EnAccess/Cicada-GSM-HW/design/source/kicad/P-1000010_Okra Cicada 2G PCBA.kicad_pcb

## KiCad design design/source/kicad/P-1000010_Okra Cicada 2G PCBA.kicad_pcb (2026-04-28)

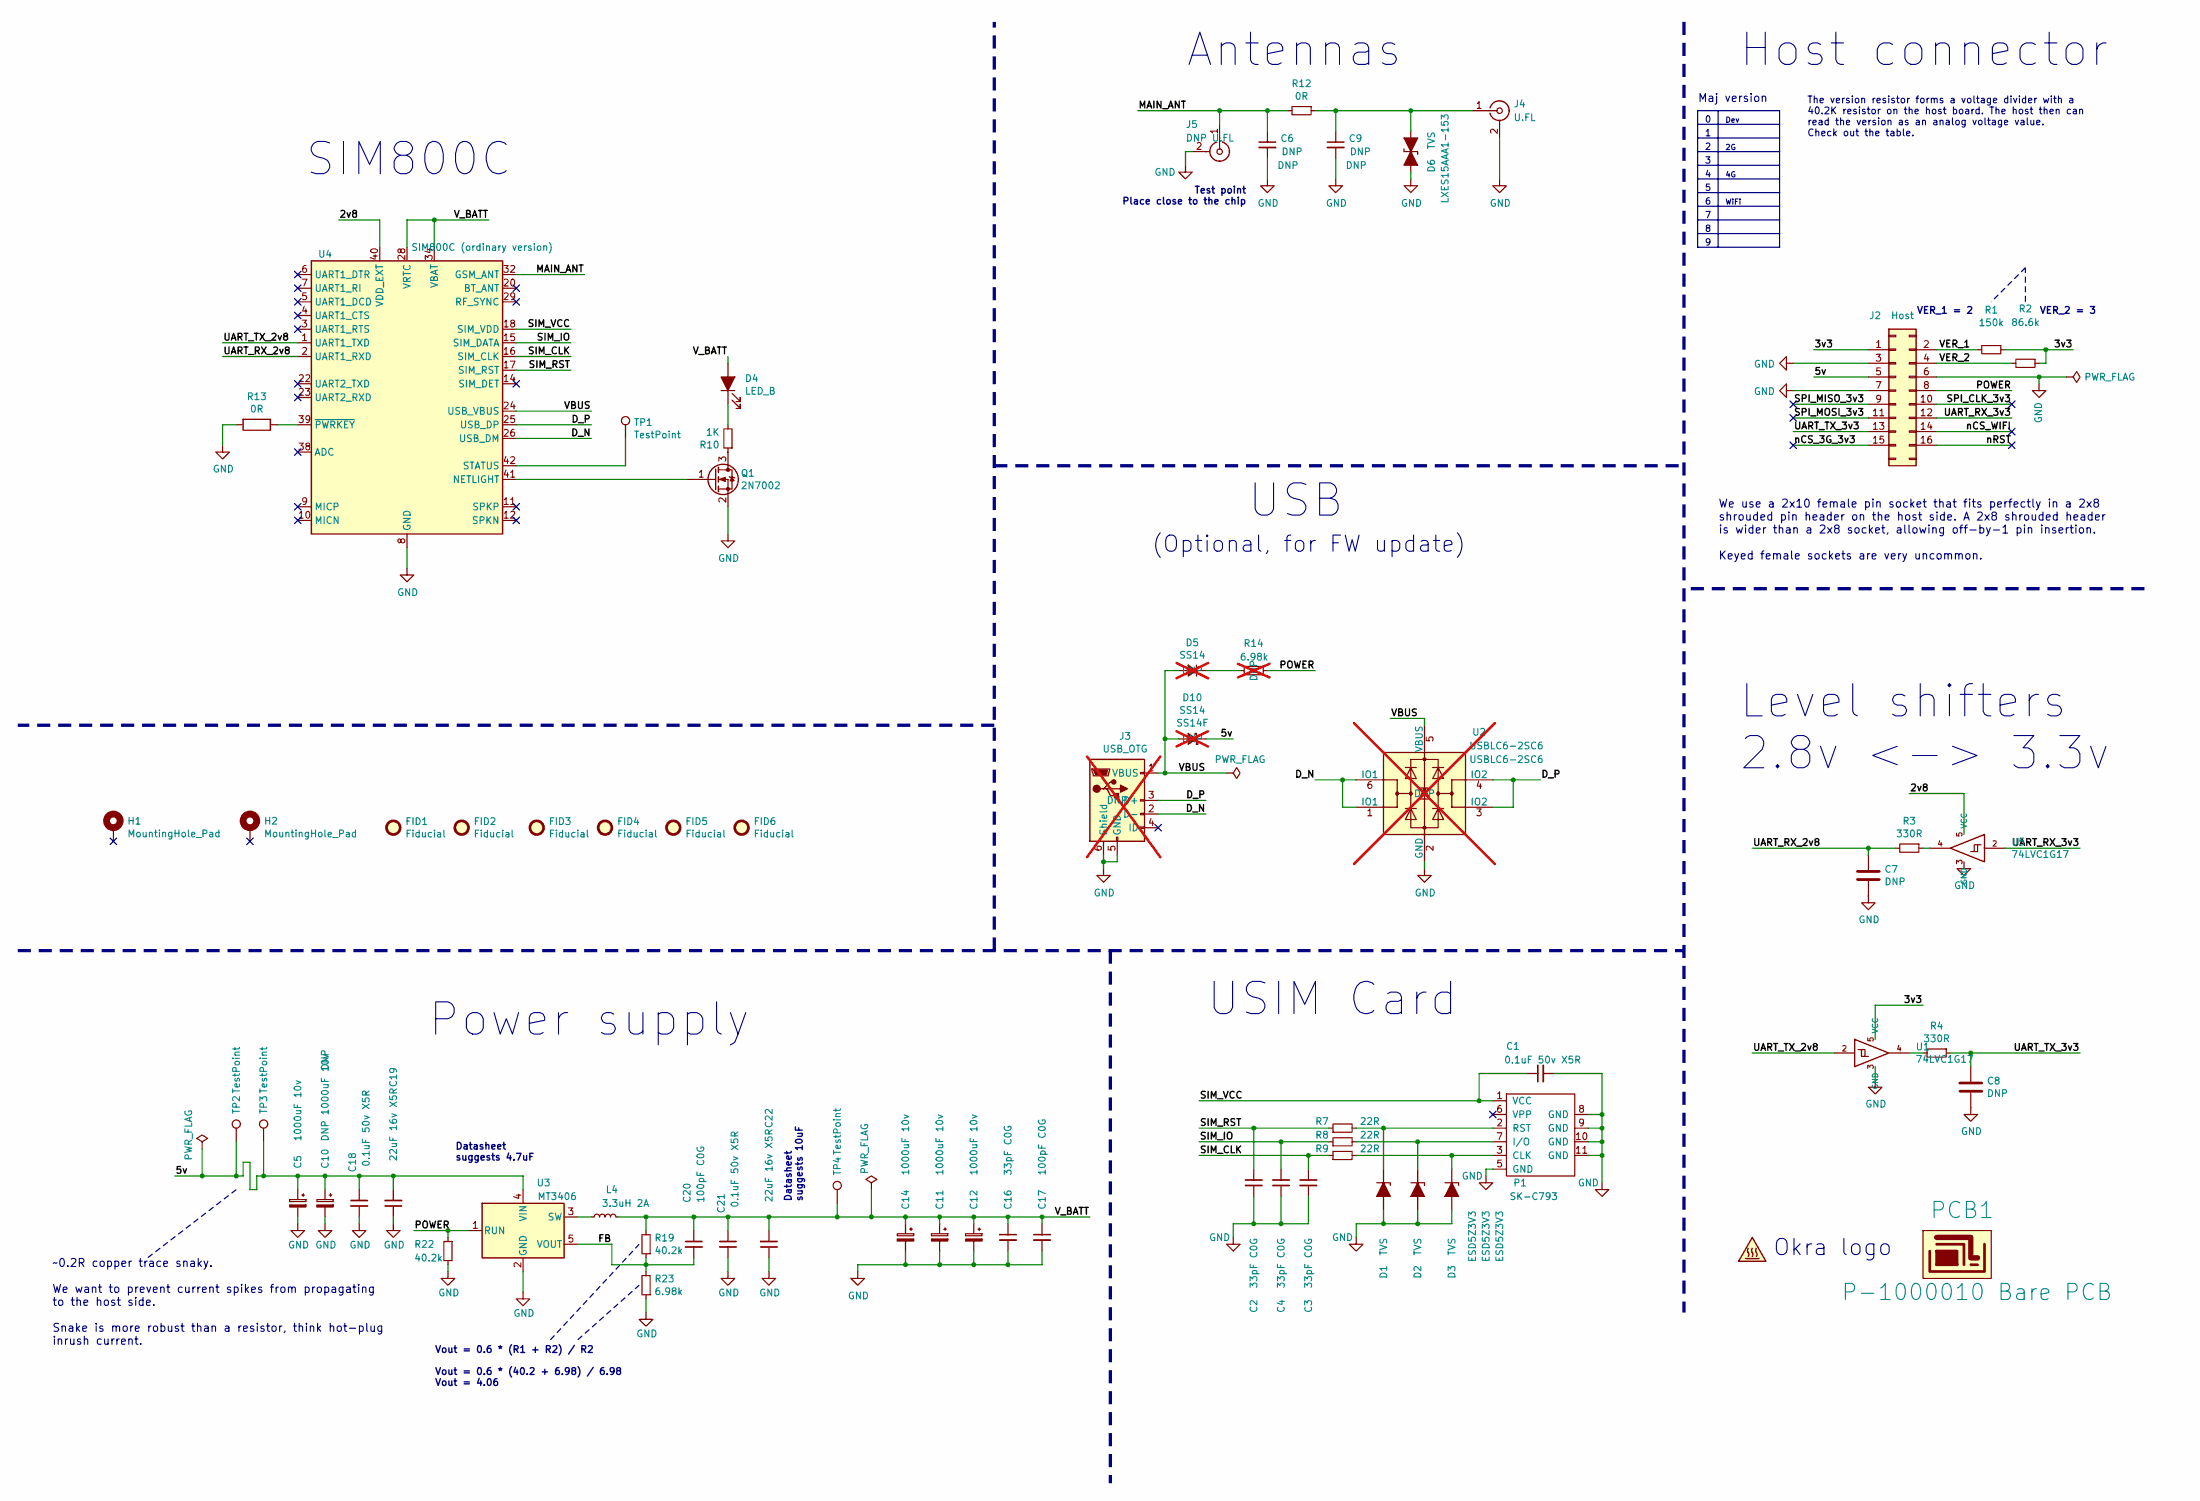
[picture p1: schematic P-1000010_Okra Cicada 2G PCBA.kicad_sch, Ciacada 2G]

Parts:
C1, C18, C21: 0.1uF 50v X5R; C_0603_1608Metric; MPN 0603B104K500NT
C2, C3, C4, C16: 33pF C0G; C_0402_1005Metric; MPN 0402CG330J500NT
C5, C11, C12, C14: 1000uF 10v; CP_Radial_D8.0mm_P3.50mm; MPN GR108M010F12RR0VL4FP0
C6, C7, C8, C9: DNP; C_0402_1005Metric
C10: DNP 1000uF 10v; CP_Radial_D8.0mm_P3.50mm; MPN GR108M010F12RR0VL4FP0
C17, C20: 100pF C0G; C_0402_1005Metric; MPN 0402CG101J500NT
C19, C22: 22uF 16v X5R; C_0805_2012Metric; MPN CL21A226MOQNNNE
D1, D2, D3: TVS; D_SOD-523; MPN ESD5Z3V3
D4: LED_B; D_0603_1608Metric; MPN ORH-B36G
D5, D10: SS14; D_SMA; MPN SS14F; not fitted
D6: TVS; D_0402_1005Metric; MPN LXES15AAA1-153
FID1, FID2, FID3, FID4, FID5, FID6: Fiducial; Fiducial_1mm_Mask2mm
H1, H2: MountingHole_Pad; MountingHole_3.2mm_M3_ISO14580_Pad
J2: Host; PinSocket_2x08_P2.54mm_Vertical_padded; MPN C30867
J3: USB_OTG; ZX62D-B-5PA8; MPN A01SB141B1-067; not fitted
J4: U.FL; U.FL_Molex_MCRF_73412-0110_Vertical; MPN U.FL-R-SMT-1(80)
J5: DNP U.FL; U.FL_Molex_MCRF_73412-0110_Vertical; MPN U.FL-R-SMT-1(80)
L4: 3.3uH 2A; L_4030_Handsoldering; MPN FPI0403F-3R3M
LOGO1: SYM_Hot_Small; okra_logo_copper_2
P1: SK-C793; MPN SK-C793
PCB1: P-1000010 Bare PCB
Q1: 2N7002; SOT-23; MPN 2N7002
R1: 150k; R_0402_1005Metric; MPN RC0402JR-07150KL
R2: 86.6k; R_0402_1005Metric; MPN RC0402FR-0786K6L
R3, R4: 330R; R_0402_1005Metric; MPN RC0402FR-07330RL
R7, R8, R9: 22R; R_0402_1005Metric; MPN RC0402FR-0722RL
R10: 1K; R_0402_1005Metric; MPN RC0402JR-071KL
R12, R13: 0R; R_0402_1005Metric; MPN RC0402FR-070RL
R14: 6.98k; R_0402_1005Metric; MPN RC0402FR-076K98L; not fitted
R19, R22: 40.2k; R_0402_1005Metric; MPN RC0402FR-0740K2L
R23: 6.98k; R_0402_1005Metric; MPN RC0402FR-076K98L
TP1, TP2, TP3, TP4: TestPoint; TestPoint_Pad_D1.5mm
U1, U5: 74LVC1G17; SOT-353_SC-70-5; MPN 74LVC1G17GW
U2: USBLC6-2SC6; SOT-23-6; MPN USBLC6-2SC6; not fitted
U3: MT3406; TSOT-23-5; MPN MT3406
U4: SIM800C (ordinary version); SIMCom_SIM800C; MPN SIM800C

Connections:
/2v8: U4.40 (VDD_EXT), U5.5 (VCC)
/3v3: J2.1, R1.1, R2.1, U1.5 (VCC)
/5v: C5.1, C10.1, C18.1, C19.2, D10.1 (K), J2.5, TP2.1, TP3.1, U3.4 (VIN)
/D_N: J3.2 (D-), U2.1 (IO1), U2.6 (IO1), U4.26 (USB_DM)
/D_P: J3.3 (D+), U2.3 (IO2), U2.4 (IO2), U4.25 (USB_DP)
/FB: C20.2, R19.1, R23.2, U3.5 (VOUT)
/MAIN_ANT: C6.1, J5.1 (In), R12.2, U4.32 (GSM_ANT)
/POWER: J2.8, R14.1, R22.1, U3.1 (RUN)
/SIM_CLK: C3.2, R9.1, U4.16 (SIM_CLK)
/SIM_IO: C4.2, R8.1, U4.15 (SIM_DATA)
/SIM_RST: C2.2, R7.1, U4.17 (SIM_RST)
/SIM_VCC: C1.1, P1.1 (VCC), U4.18 (SIM_VDD)
/SPI_CLK_3v3: J2.10
/SPI_MISO_3v3: J2.9
/SPI_MOSI_3v3: J2.11
/UART_RX_2v8: C7.1, R3.2, U4.2 (UART1_RXD)
/UART_RX_3v3: J2.12, U5.2
/UART_TX_2v8: U1.2, U4.1 (UART1_TXD)
/UART_TX_3v3: C8.1, J2.13, R4.1
/VBUS: D5.2 (A), D10.2 (A), J3.1 (VBUS), U2.5 (VBUS), U4.24 (USB_VBUS)
/VER_1: J2.2, R1.2
/VER_2: J2.4, R2.2
/V_BATT: C11.1, C12.1, C14.1, C16.1, C17.1, C20.1, C21.1, C22.2, D4.2 (A), L4.2, R19.2, TP4.1, U4.28 (VRTC), U4.34 (VBAT), U4.35 (VBAT)
/nCS_3G_3v3: J2.15
/nCS_WIFI: J2.14
/nRST: J2.16
GND: C1.2, C2.1, C3.1, C4.1, C5.2, C6.2, C7.2, C8.2, C9.2, C10.2, C11.2, C12.2, C14.2, C16.2, C17.2, C18.2, C19.1, C21.2, C22.1, D1.2 (A), D2.2 (A), D3.2 (A), D6.2 (A2), J2.3, J2.6, J2.7, J3.5 (GND), J3.6 (Shield), J4.2 (Ext), J5.2 (Ext), P1.5 (GND), P1.8 (GND), P1.9 (GND), P1.10 (GND), P1.11 (GND), Q1.2 (S), R13.2, R22.2, R23.1, U1.3 (GND), U2.2 (GND), U3.2 (GND), U4.8 (GND), U4.13 (GND), U4.19 (GND), U4.21 (GND), U4.27 (GND), U4.30 (GND), U4.31 (GND), U4.33 (GND), U4.36 (GND), U4.37 (GND), U5.3 (GND)
unnamed: C9.1, D6.1 (A1), J4.1 (In), R12.1
unnamed: D1.1 (K), P1.2 (RST), R7.2
unnamed: D2.1 (K), P1.7 (I/O), R8.2
unnamed: D3.1 (K), P1.3 (CLK), R9.2
unnamed: D4.1 (K), R10.2
unnamed: D5.1 (K), R14.2
unnamed: L4.1, U3.3 (SW)
unnamed: Q1.1 (G), U4.41 (NETLIGHT)
unnamed: Q1.3 (D), R10.1
unnamed: R3.1, U5.4
unnamed: R4.2, U1.4
unnamed: R13.1, U4.39 (~PWRKEY)
unnamed: TP1.1, U4.42 (STATUS)

Notes on the sheet:
Datasheet suggests 10uF
Antennas
Power supply
Datasheet suggests 4.7uF
(Optional, for FW update)
Level shifters 2.8v <-> 3.3v
Okra logo
SIM800C
WiFi
USIM Card
The version resistor forms a voltage divider with a 40.2K resistor on the host board. The host then can read the version as an analog voltage value. Check out the table.
USB
Test point Place close to the chip
Maj version
Vout = 0.6 * (R1 + R2) / R2 Vout = 0.6 * (40.2 + 6.98) / 6.98 Vout = 4.06
~0.2R copper trace snaky. We want to prevent current spikes from propagating to the host side. Snake is more robust than a resistor, think hot-plug inrush current.
Dev
We use a 2x10 female pin socket that fits perfectly in a 2x8 shrouded pin header on the host side. A 2x8 shrouded header is wider than a 2x8 socket, allowing off-by-1 pin insertion. Keyed female sockets are very uncommon.
VER_2 = 3
Host connector
VER_1 = 2

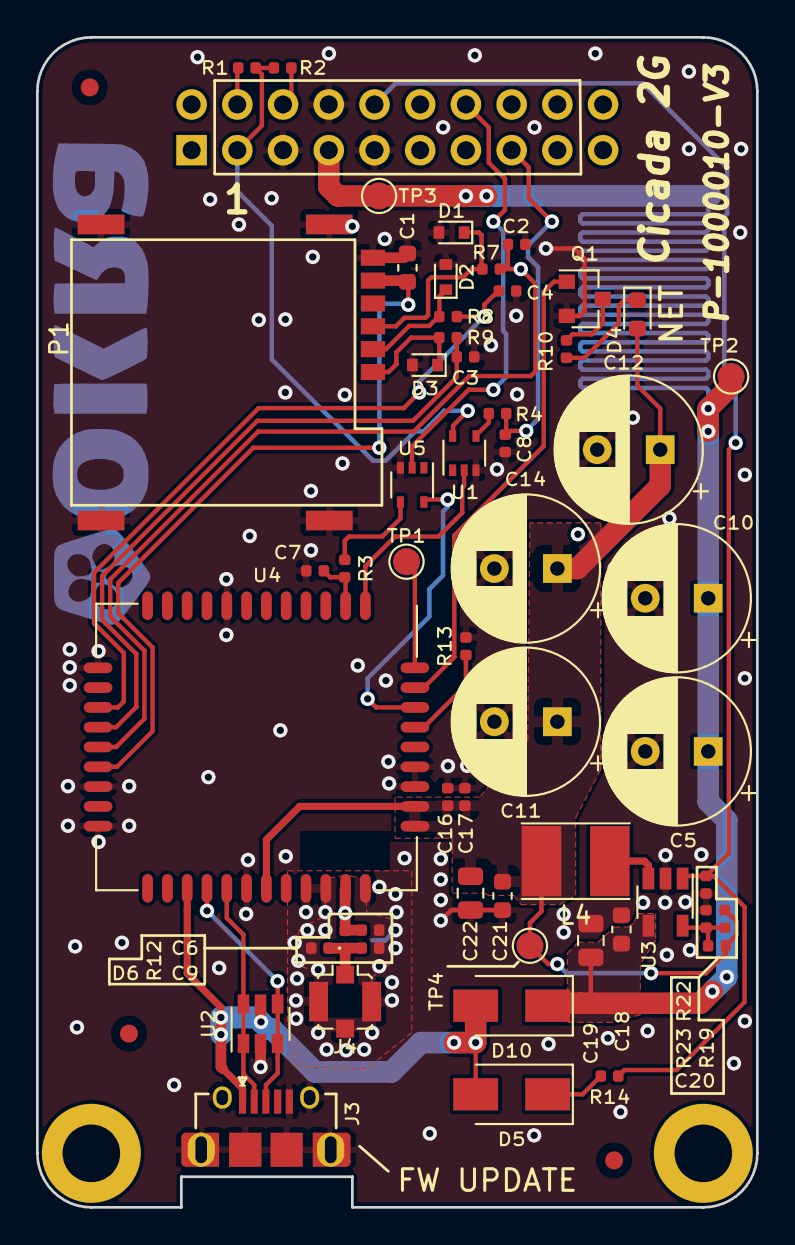
[picture p2: board P-1000010_Okra Cicada 2G PCBA.kicad_pcb from above]

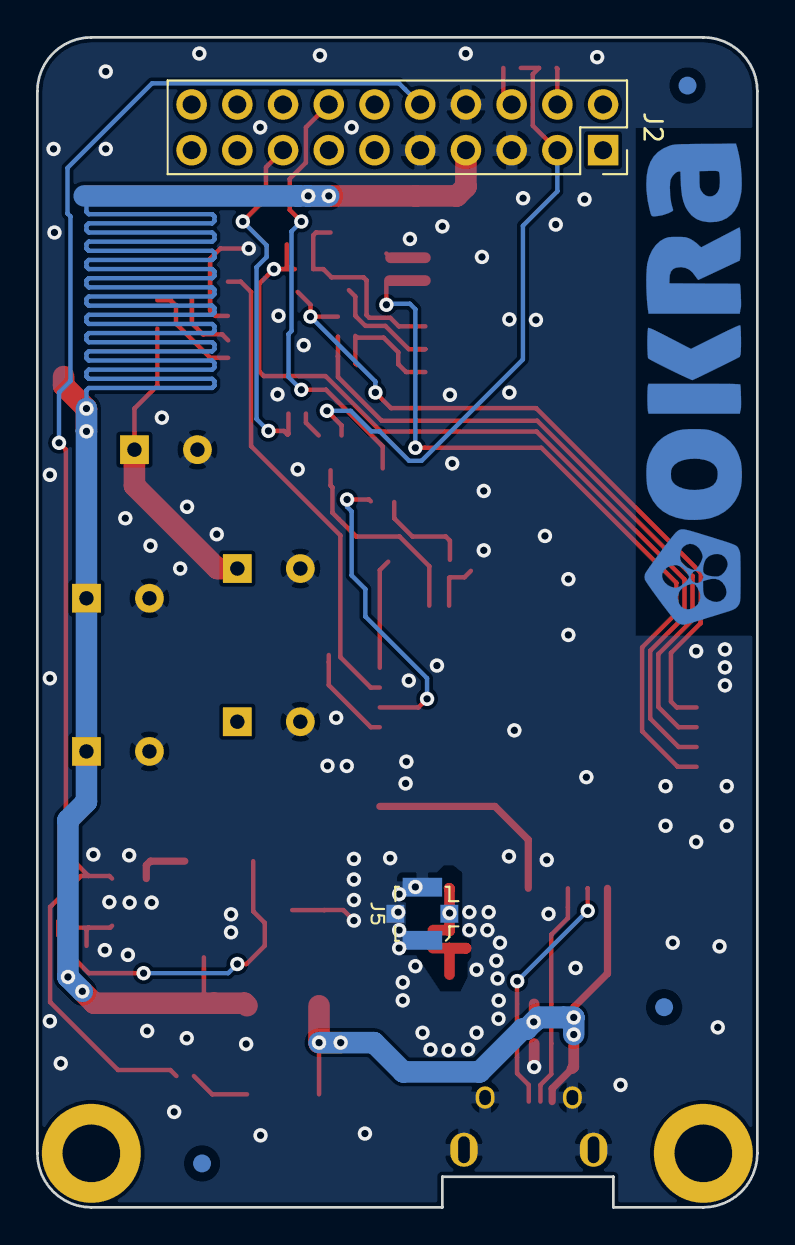
[picture p3: board P-1000010_Okra Cicada 2G PCBA.kicad_pcb from below]

Board: 2 copper layers, 40.0 x 65.0 mm, 66 parts (6 on the bottom side), 34 nets.
