EnAccess/Cicada-GSM-HW/design/source/kicad/cicada-4g/P-1000011_Okra Cicada 4G PCBA.kicad_pcb

## KiCad design design/source/kicad/cicada-4g/P-1000011_Okra Cicada 4G PCBA.kicad_pcb (2023-07-25)

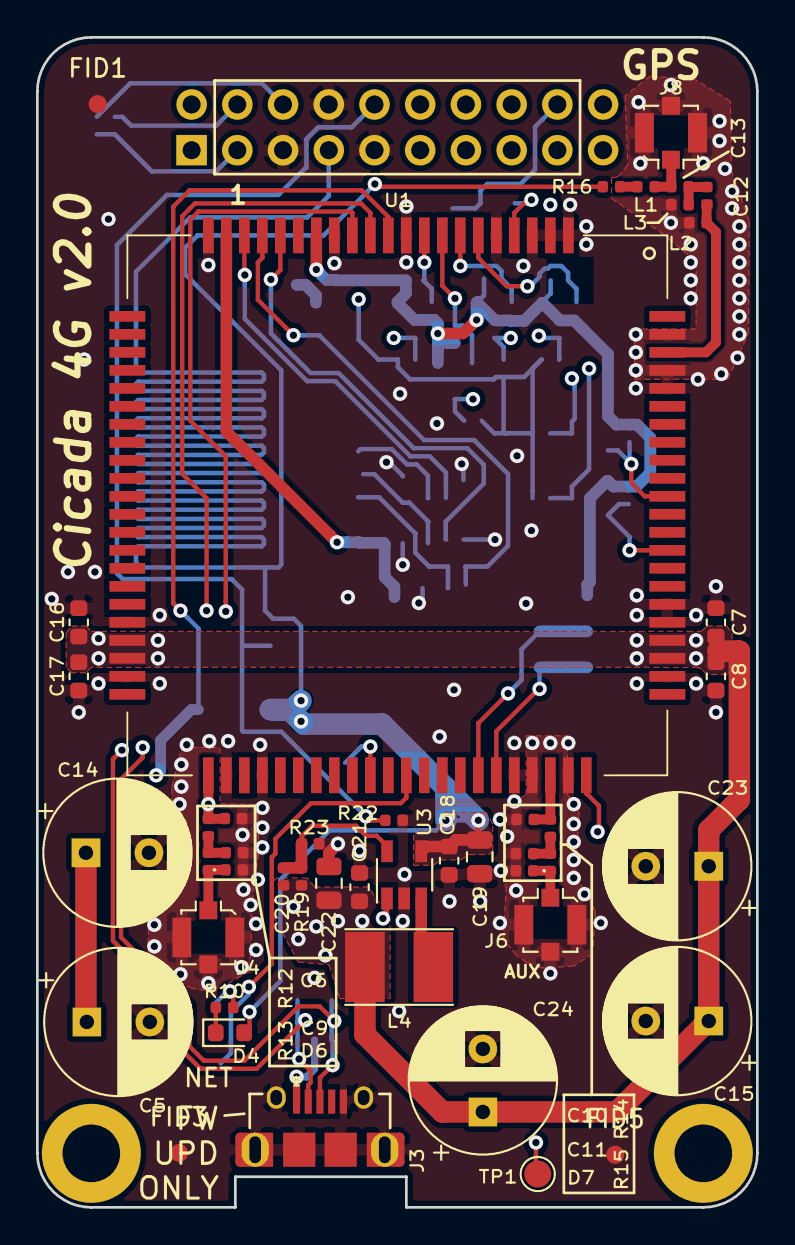
[picture p4: board P-1000011_Okra Cicada 4G PCBA.kicad_pcb from above]

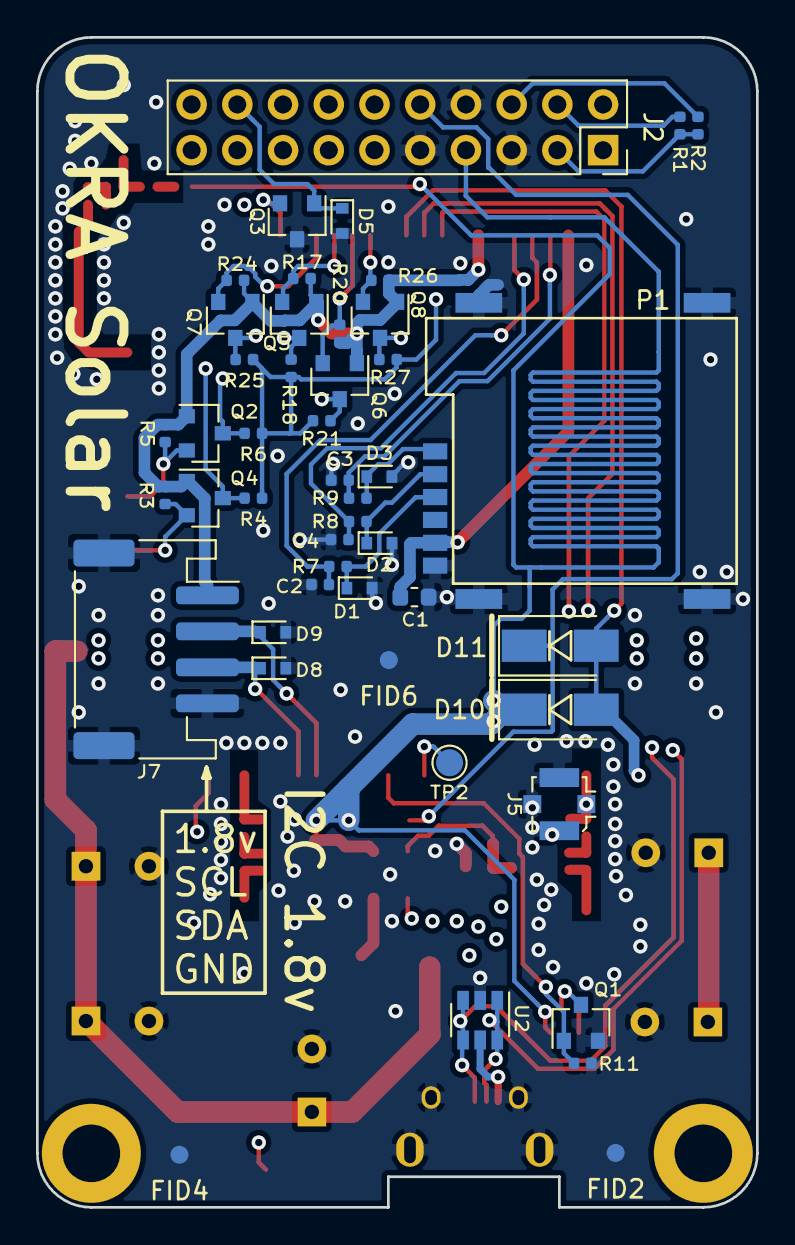
[picture p5: board P-1000011_Okra Cicada 4G PCBA.kicad_pcb from below]

Board: 4 copper layers, 40.0 x 65.0 mm, 95 parts (47 on the bottom side), 51 nets.

Parts:
C1, C8, C17, C18, C21: 0.1uF 50v X5R; C_0603_1608Metric
C2, C3, C4, C13: 33pF C0G; C_0402_1005Metric
C5, C14, C15, C23, C24: 1000uF 10v; CP_Radial_D8.0mm_P3.50mm
C6, C9, C10, C11, C12: DNP; C_0402_1005Metric
C7, C16: 1uF 16v X5R; C_0603_1608Metric
C19, C22: 22uF 16v X5R; C_0805_2012Metric
C20: 100pF C0G; C_0402_1005Metric
D1, D2, D3, D5, D8, D9: TVS; D_SOD-523
D4: LED_B; D_0603_1608Metric
D6, D7: TVS; D_0402_1005Metric
D10, D11: SS14; D_SMA
FID1, FID2, FID3, FID4, FID5, FID6: Fiducial; Fiducial_1mm_Mask2mm
H1, H2: MountingHole_Pad; MountingHole_3.2mm_M3_ISO14580_Pad
J2: Host; PinSocket_2x08_P2.54mm_Vertical_padded
J3: USB_OTG; ZX62D-B-5PA8
J4, J5, J6, J8: IPX; U.FL_Molex_MCRF_73412-0110_Vertical
J7: Conn_01x04; JST_PH_S4B-PH-SM4-TB_1x04-1MP_P2.00mm_Horizontal
L1: 47nH; L_0402_1005Metric
L2, L3: DNP; L_0402_1005Metric
L4: 3.3uH 2A; L_4030_Handsoldering
P1: SK-C793
Q1, Q2, Q4, Q5, Q6, Q7, Q8: NMOS; SOT-23
Q3: PMOS; SOT-23
R1: 54.9k; R_0402_1005Metric
R2: 340k; R_0402_1005Metric
R3, R4, R5, R6, R17, R18, R20, R21, R24, R25, R26, R27: 4.7k; R_0402_1005Metric
R7, R8, R9: 22R; R_0402_1005Metric
R10: 470R; R_0402_1005Metric
R11, R19, R22: 40.2k; R_0402_1005Metric
R12, R13, R14, R15: 0R; R_0402_1005Metric
R16: 10R; R_0402_1005Metric
R23: 6.98k; R_0402_1005Metric
TP1, TP2: TestPoint; TestPoint_Pad_D1.5mm
U1: sim7600
U2: USBLC6-2SC6; SOT-23-6
U3: M3406-ADJ; TSOT-23-5

Connections:
/1v8: J7.1, Q2.1, Q4.1, Q5.1, Q6.1, Q7.1, Q8.1, R3.1, R5.1, R17.1, R20.1, R24.1, R26.1, U1.15
/3v3: J2.1, R1.1, R2.1, R4.1, R6.1, R18.1, R21.1, R25.1, R27.1
/5v: C5.1, C14.1, C18.1, C19.2, D4.2, D10.1, J2.5, R16.2, U3.4
/AUX_ANT: C10.1, R14.2, U1.59
/D_N: J3.2, U1.12, U2.1, U2.6
/D_P: J3.3, U1.13, U2.3, U2.4
/FB: C20.2, R19.1, R23.2, U3.5
/GNSS_ANT: C12.1, L2.1, U1.79
/MAIN_ANT: C6.1, J5.1, R12.2, U1.82
/POWER: D11.1, J2.8, R22.1, U3.1
/SIM_CLK: C3.2, R9.1, U1.19
/SIM_IO: C4.2, R8.1, U1.17
/SIM_RST: C2.2, R7.1, U1.18
/SIM_VCC: C1.1, P1.1, U1.20
/SPI_CLK_1v8: Q7.2, R24.2, U1.6
/SPI_CLK_3v3: J2.10, Q7.3, R25.2
/SPI_CS_1v8: Q8.2, R26.2, U1.9
/SPI_MISO_1v8: Q5.2, R17.2, U1.7
/SPI_MISO_3v3: J2.9, Q5.3, R18.2
/SPI_MOSI_1v8: Q6.2, R20.2, U1.8
/SPI_MOSI_3v3: J2.11, Q6.3, R21.2
/UART_RX_1v8: Q4.2, R3.2, U1.68
/UART_RX_3v3: J2.12, Q4.3, R4.2
/UART_TX_1v8: Q2.2, R5.2, U1.71
/UART_TX_3v3: J2.13, Q2.3, R6.2
/VBUS: D10.2, D11.2, J3.1, U1.11, U2.5
/VER_1: J2.2, R1.2
/VER_2: J2.4, R2.2
/V_BATT: C7.1, C8.1, C15.1, C16.1, C17.1, C20.1, C21.1, C22.2, C23.1, C24.1, L4.2, R19.2, U1.38, U1.39, U1.62, U1.63
/nCS_3G_3v3: J2.15, Q8.3, R27.2
/nRST: D5.1, J2.16, Q3.1
GND: C1.2, C2.1, C3.1, C4.1, C5.2, C6.2, C7.2, C8.2, C9.2, C10.2, C11.2, C14.2, C15.2, C16.2, C17.2, C18.2, C19.1, C21.2, C22.1, C23.2, C24.2, D1.2, D2.2, D3.2, D5.2, D6.2, D7.2, D8.2, D9.2, J2.3, J2.6, J2.7, J3.5, J3.6, J4.2, J5.2, J6.2, J7.4, J7.MP, J8.2, L2.2, L3.2, P1.5, P1.8, P1.9, P1.10, P1.11, Q1.2, Q3.3, R11.2, R22.2, R23.1, U1.1, U1.2, U1.3, U1.5, U1.10, U1.14, U1.37, U1.40, U1.41, U1.43, U1.57, U1.58, U1.60, U1.61, U1.64, U1.65, U1.77, U1.78, U1.80, U1.81, U2.2, U3.2
unnamed: C9.1, R12.1, R13.2
unnamed: C11.1, R14.1, R15.2
unnamed: C12.2, C13.2, L3.1
unnamed: C13.1, J8.1, L1.2
unnamed: D1.1, P1.2, R7.2
unnamed: D2.1, P1.7, R8.2
unnamed: D3.1, P1.3, R9.2
unnamed: D4.1, R10.1
unnamed: D6.1, J4.1, R13.1
unnamed: D7.1, J6.1, R15.1
unnamed: D8.1, J7.3, U1.56
unnamed: D9.1, J7.2, U1.55
unnamed: L1.1, R16.1
unnamed: L4.1, U3.3
unnamed: Q1.1, R11.1, U1.51
unnamed: Q1.3, R10.2
unnamed: Q3.2, U1.4
unnamed: TP1.1, U1.85
unnamed: TP2.1, U1.49
